Barbalho12/Tetris-3D/README.md

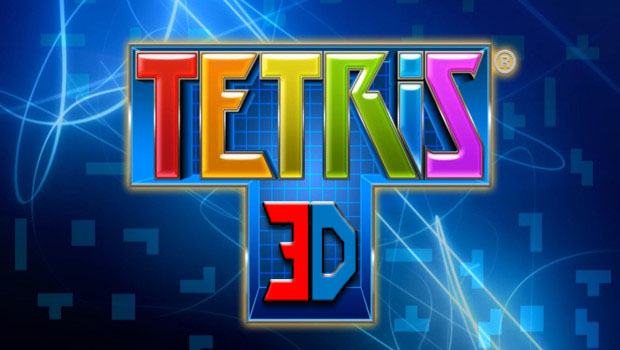
[picture p1: DOCs/Images/teris3d-logo.jpg]


The classic Tetris game on a hologram.
