Barbalho12/Tetris-3D/DOCs/Presentations/TETRIS 3D - Final Presentation.pdf

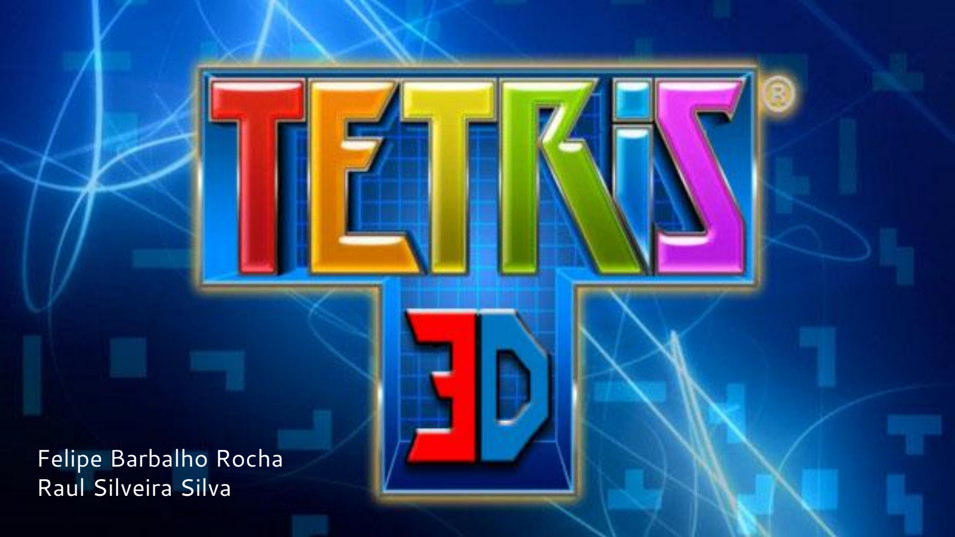
[picture p17: page 1]

Felipe Barbalho Rocha
Raul Silveira Silva

## Outline

- Motivação;
- O sistema;
- Problemas de desenvolvimento;
- Andamento;
- Trabalhos futuros.

## Motivação

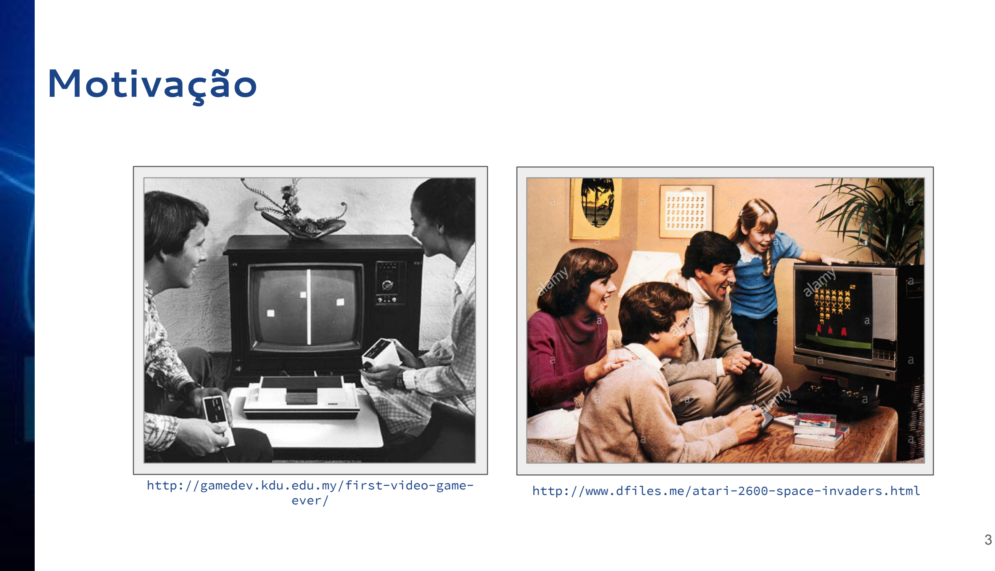
[picture p18: page 3]

http://gamedev.kdu.edu.my/first-video-gameever/

http://www.dfiles.me/atari-2600-space-invaders.html

## Motivação

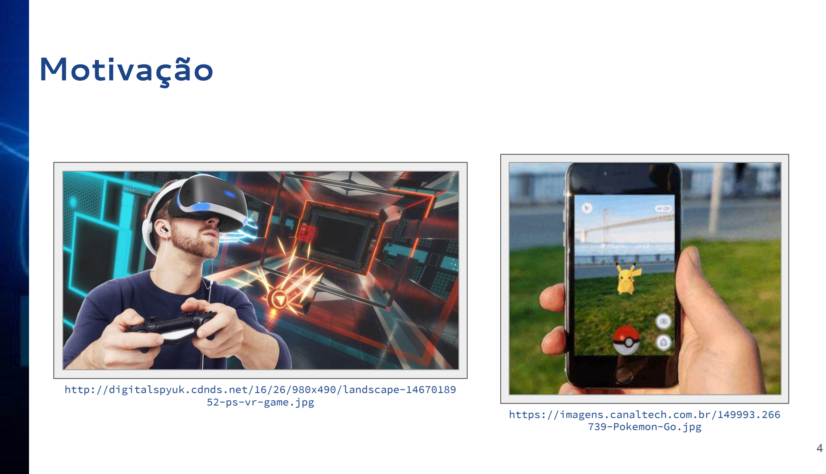
[picture p19: page 4]

http://digitalspyuk.cdnds.net/16/26/980x490/landscape-14670189 52-ps-vr-game.jpg
https://imagens.canaltech.com.br/149993.266 739-Pokemon-Go.jpg

## O Sistema

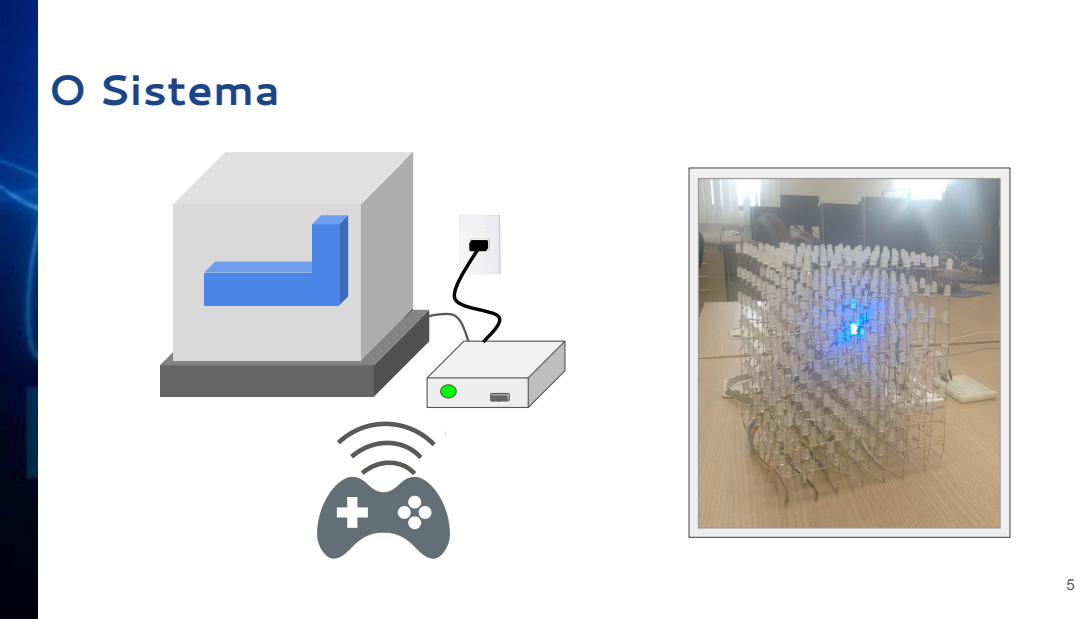
[picture p20: page 5]

## Especificação do hardware

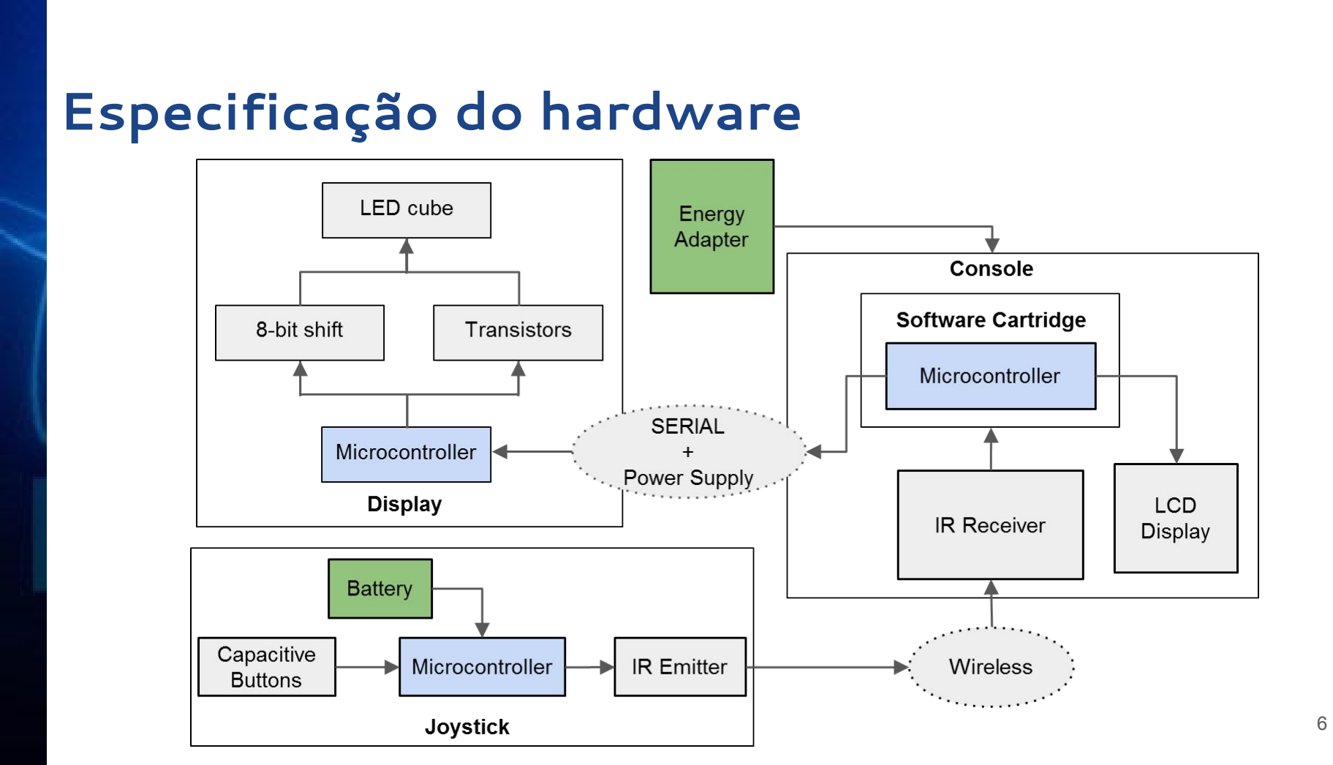
[picture p21: page 6]

## Limitações

- Comunicação infravermelho do joystick com o console;
- Velocidade de leitura dos comandos do jogo;
- Exibição de objetos no cubo.

## Andamento

Projeto Inicial | Estado
Comunicação sem fio do Josytick | Modificado para comunicação Serial com fio
Joystick com pequenas dimensões | Tamanho maior do que o especificado
Cubo de LEDs | Finalizado
Hardware do Console | Finalizado
Hardware do Joystick | 90% concluído
Tetris | Em andamento

- O sistema pode ser usado para diversas aplicações, não somente o Tetris;
- Exemplos:
- Ploter para gráficos 3D;
- Pequenas animações;
- Outros jogos.
- Melhorar a adaptabilidade para novas aplicações;
- Criar PCBs;
- Novo Joystick com 3 encoders rotativos.

## Trabalhos futuros

Felipe Barbalho Rocha
Raul Silveira Silva
