Barbalho12/Tetris-3D/DOCs/Images/Bloc Diagram.png

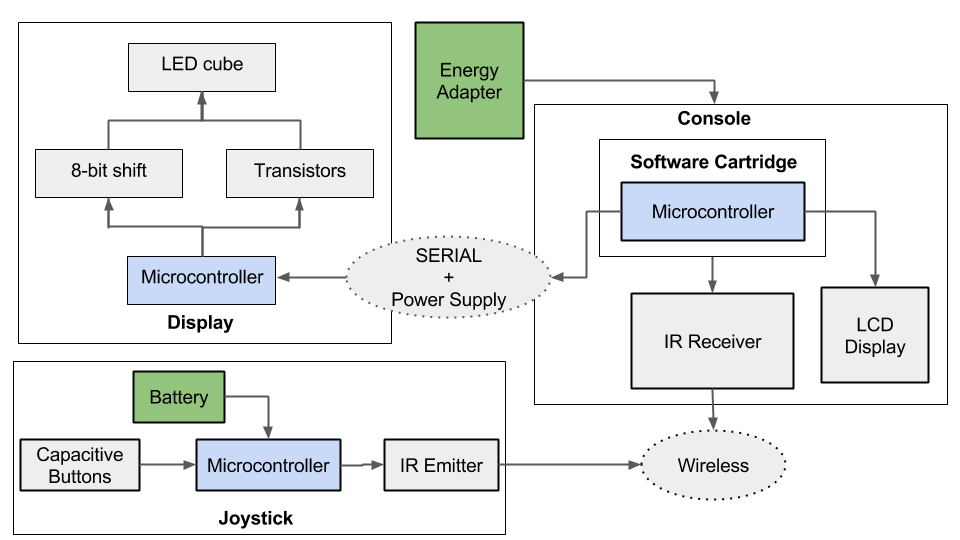
DOCs/Images/Bloc Diagram.png
