Barbalho12/Tetris-3D/DOCs/Images/circuito.png

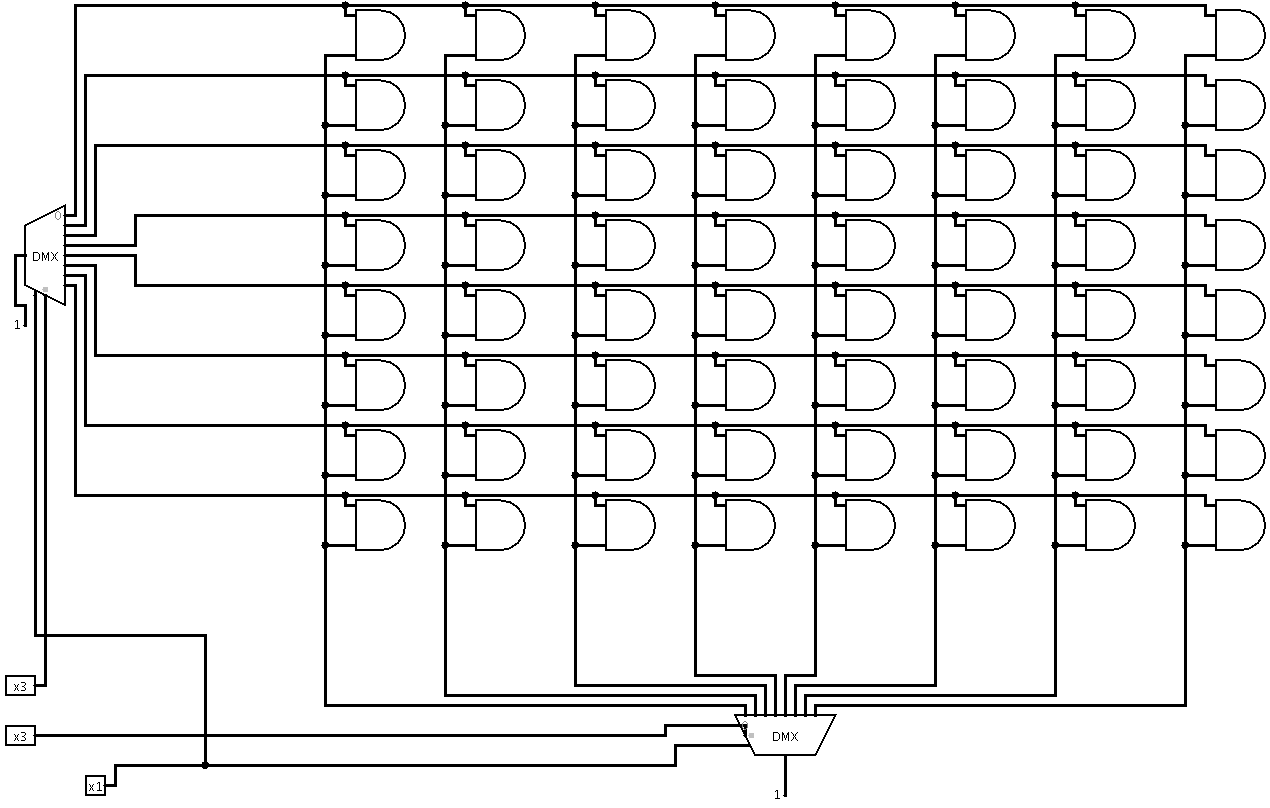
DOCs/Images/circuito.png
