Barbalho12/Tetris-3D/DOCs/Images/Diagrama de atividades.png

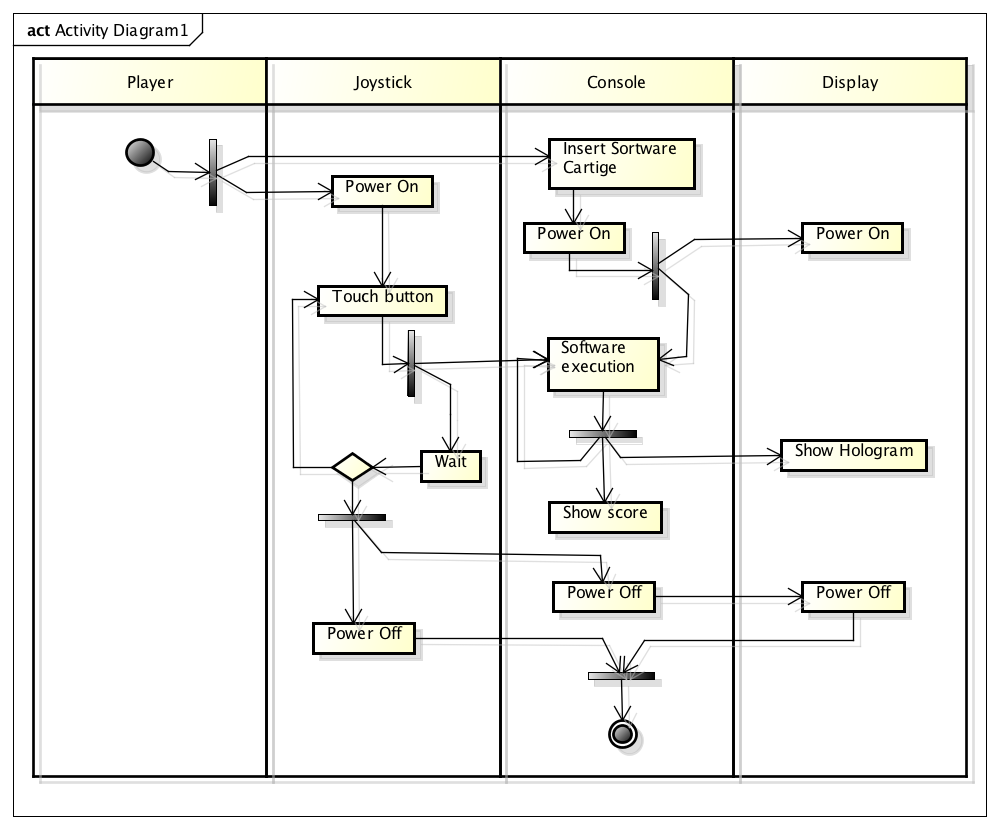
DOCs/Images/Diagrama de atividades.png
