Barbalho12/Tetris-3D/DOCs/Images/Equema3_bb.png

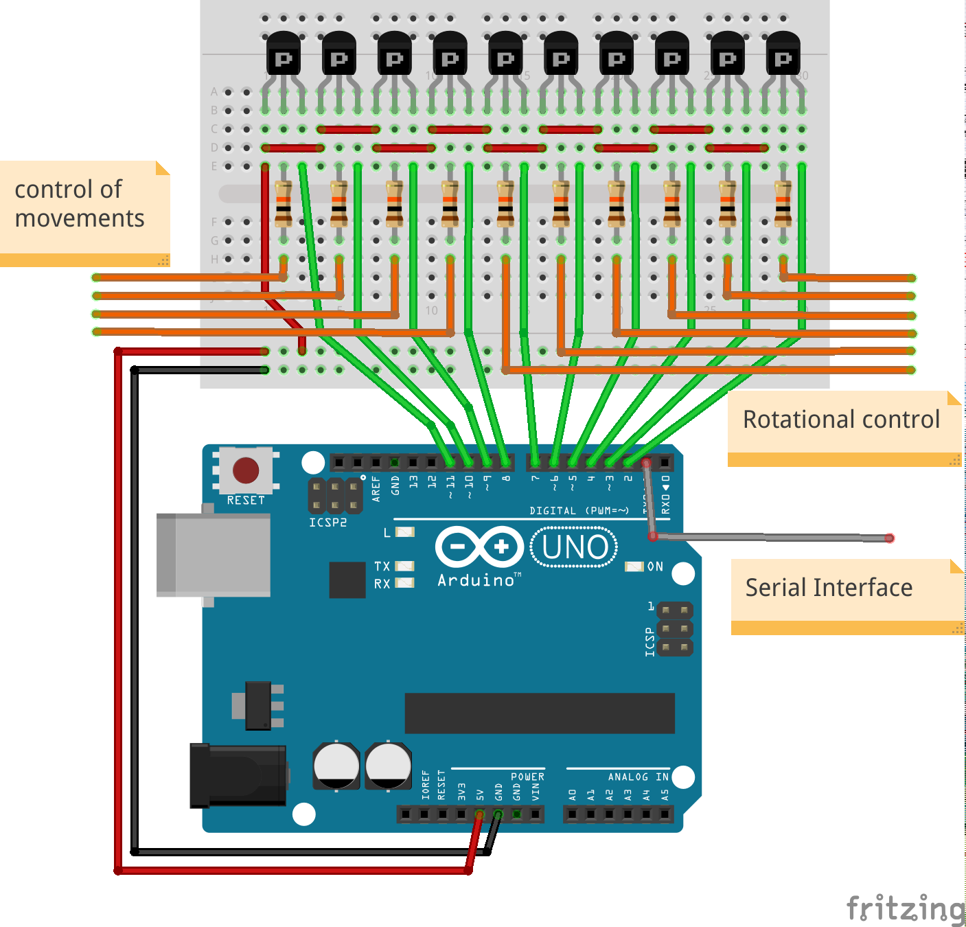
DOCs/Images/Equema3_bb.png
