Barbalho12/Tetris-3D/DOCs/Images/Equema4_bb.png

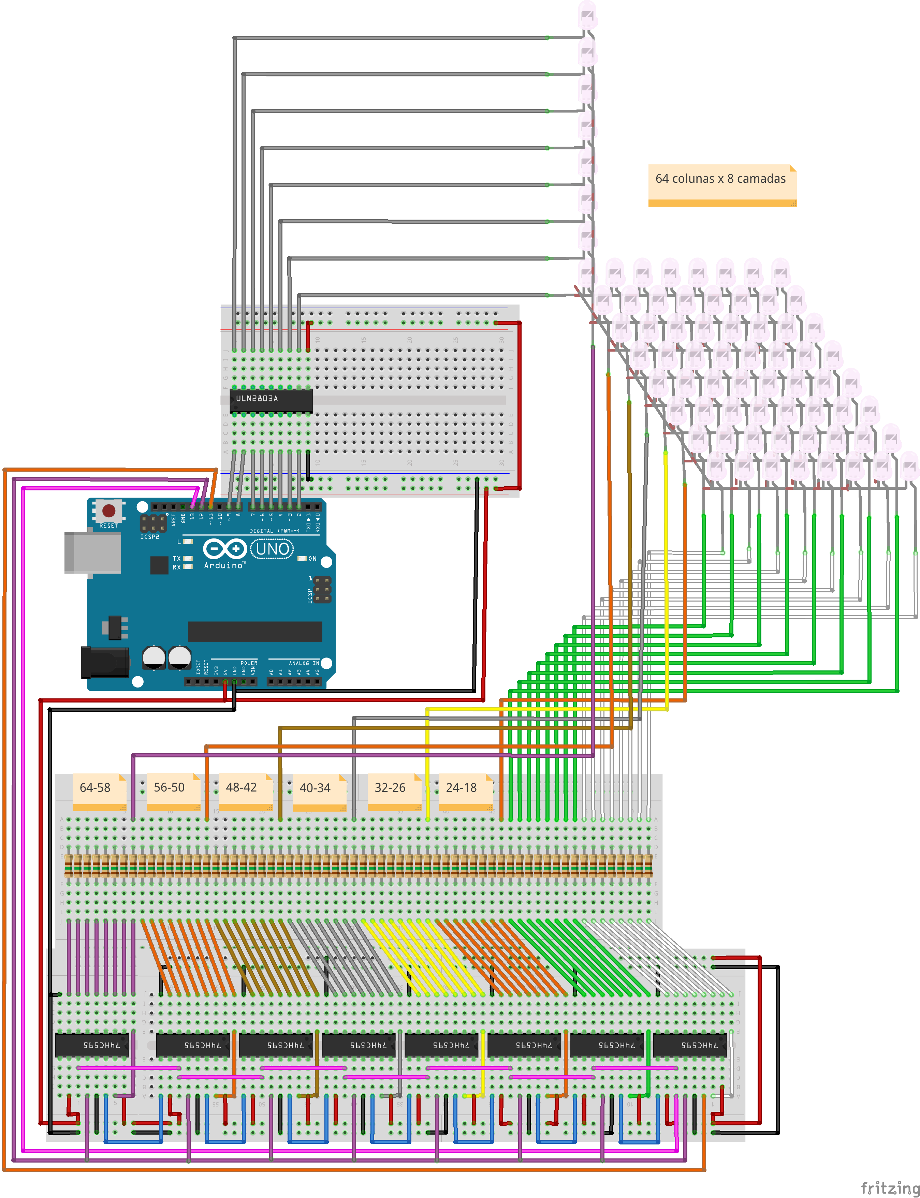
DOCs/Images/Equema4_bb.png
