Barbalho12/Tetris-3D/DOCs/Images/Esquema2_bb.png

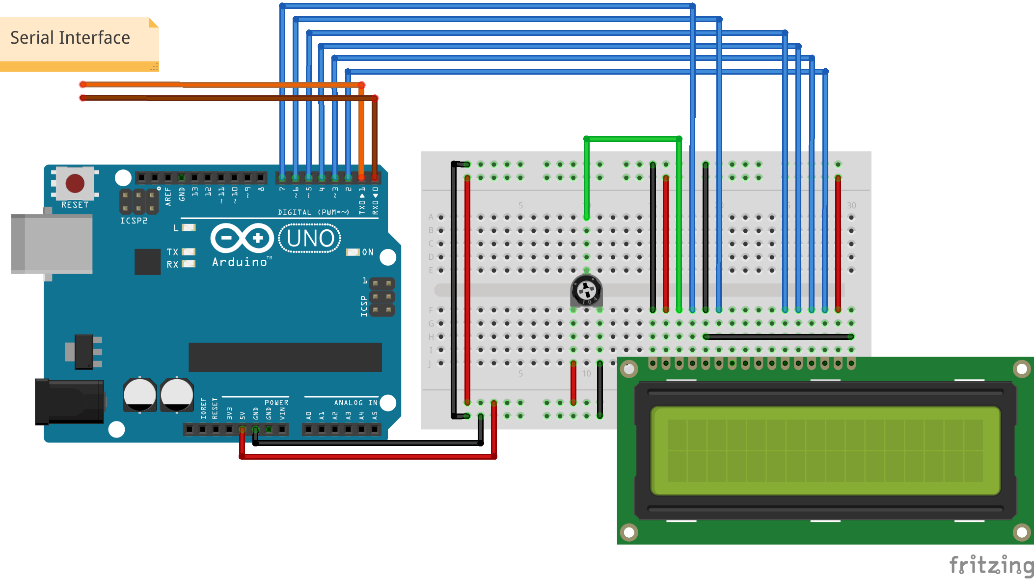
DOCs/Images/Esquema2_bb.png
