Barbalho12/Tetris-3D/DOCs/Images/jogo.png

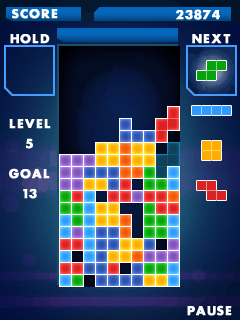
DOCs/Images/jogo.png
