Barbalho12/Tetris-3D/(list of files, drawings)

Other design files:
DOCs/Equema3.fzz
DOCs/Equema4.fzz
DOCs/Esquema2.fzz
DOCs/projeto-circuito.circ
