Barbalho12/Tetris-3D/(commit log)

2016-11-11 [Joystick] - Code for the buttons
2016-11-16 [DOCs] Images, diagrams, presentations and reports were imported
    [Equema.fzz, projeto-circuito.circ]
2016-11-16 Edit Use Case Diagram
2016-11-17 [DOCS] - Schematics added
    [Equema3.fzz, Equema4.fzz, Esquema2.fzz]
2016-12-07 Console with standard descent movement with time interruption
2016-12-09 Update Schematic
    [Equema.fzz, Equema3.fzz, Equema4.fzz, Esquema2.fzz]
2017-10-18 Print removed
